LucaTomei/Electric-Scooter-Wheelchair/docs/speeches/V3-ENGLISH VERSION - DISCORSO TESI.pdf

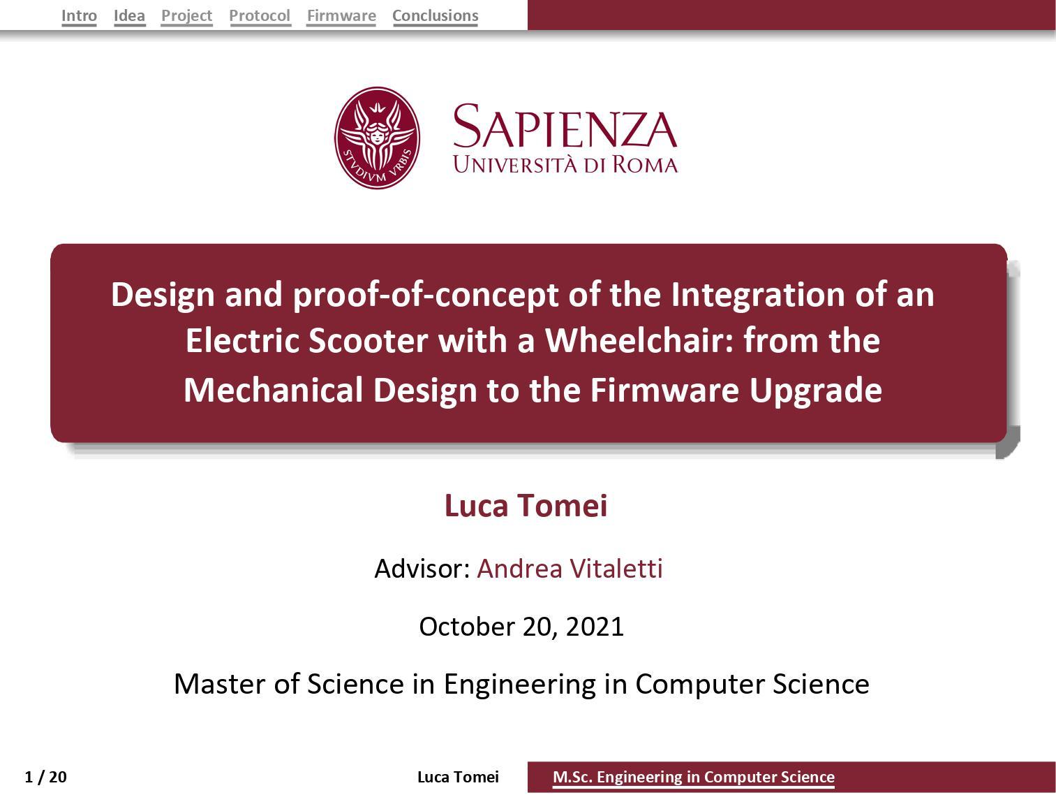
[picture p2: figure]

SLIDE 1
Good morning everyone, I'm Luca Tomei and I am going to show the presentation of my thesis work whose title is "Design and proof-of-concept of the Integration of an Electric Scooter with a Wheelchair: from the Mechanical Design to the Firmware Upgrade".

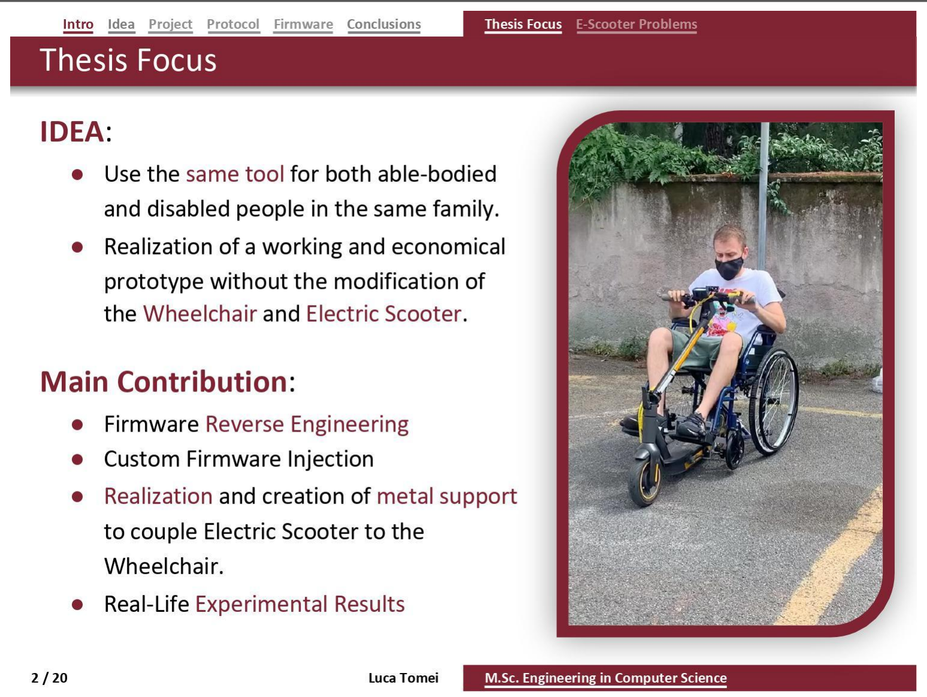
[picture p3: figure]

SLIDE 2
The aim of the project is to extend the use of an electric scooter to people with disabilities so that the same family can share the same means of motion. It was decided to not make any changes to neither the wheelchair nor the electric scooter, making as easy as possible for the two parts to be coupled and used together. But we have found two main problems: First. we must allow the electric scooter to start from a standstill and Second. we need to create the coupling of the two components.
Since the firmware of an electric scooter is owned by the manufacturer and is not available, it was decided to reverse engineer it by monitoring the packets exchanged between the smartphone and the vehicle.
As will be shown, this leads to a serious security problem in this IT product and after extracting and modifying the encrypted firmware, we made a steel bracket that allows attachment to a wheelchair. Finally, road tests were carried out to analyse the behavior of this software modification in order to make improvements and obtain data that would make driving safe without causing damage to people, battery or other components.

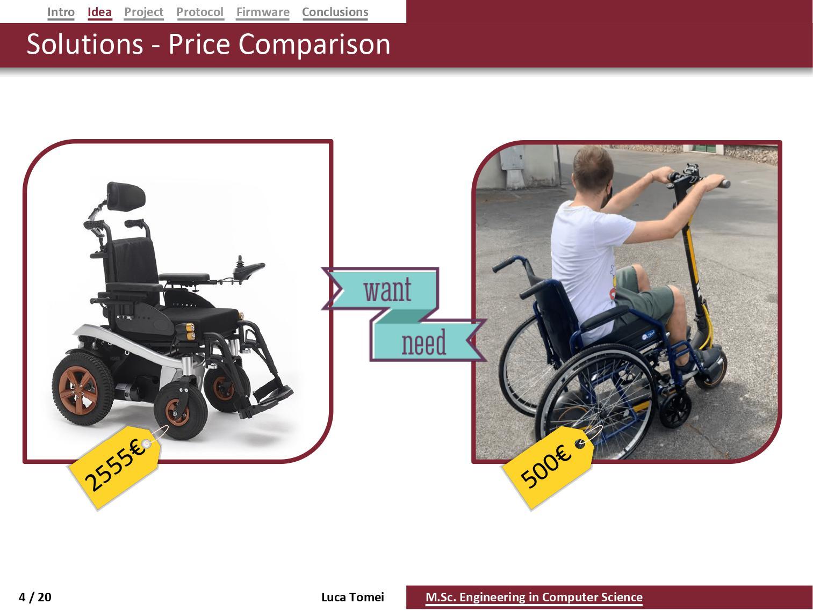
[picture p4: figure]

SLIDE 4
To overcome this problem, this project provides a different use of the wheelchair and electric scooter and, as is shown in this slide by a price comparison, it is possible to add traction to a normal wheelchair at a lower cost than a motorised one.

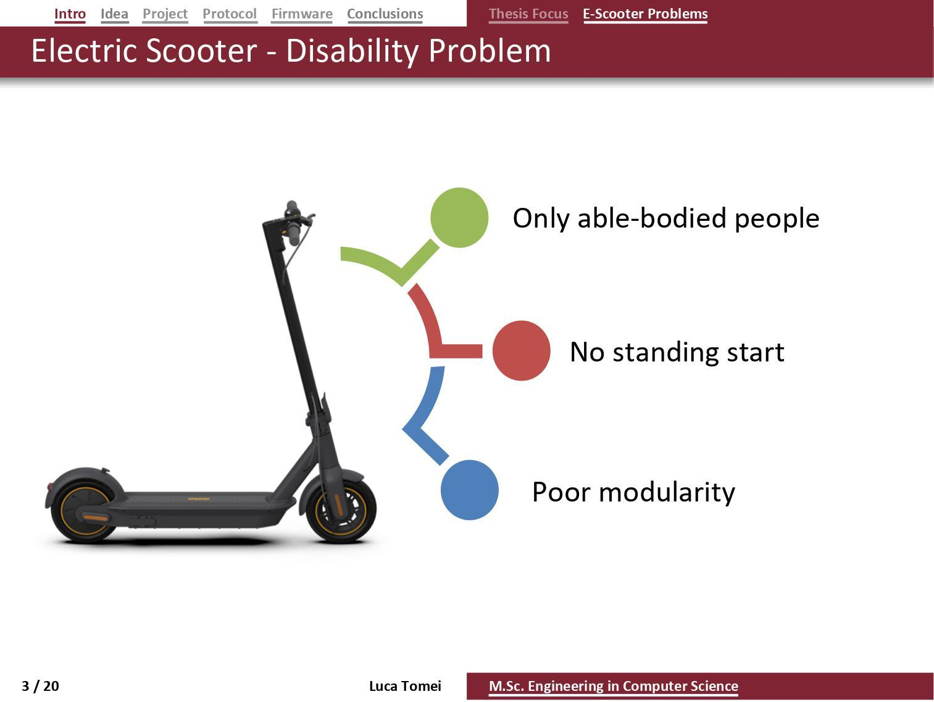
[picture p5: figure]

SLIDE 3
The popularity of electric scooters has increased in recent years.
However, the structure of such a vehicle imposes several constraints that apparently cannot be overcome by disabled people: for example, they can only be ridden by who can stand up and there is no possibility to start from a standstill as a small push with the feet is required to start the ride. Finally, electric scooters have little modularity, that is they are difficult to adapt to various uses.

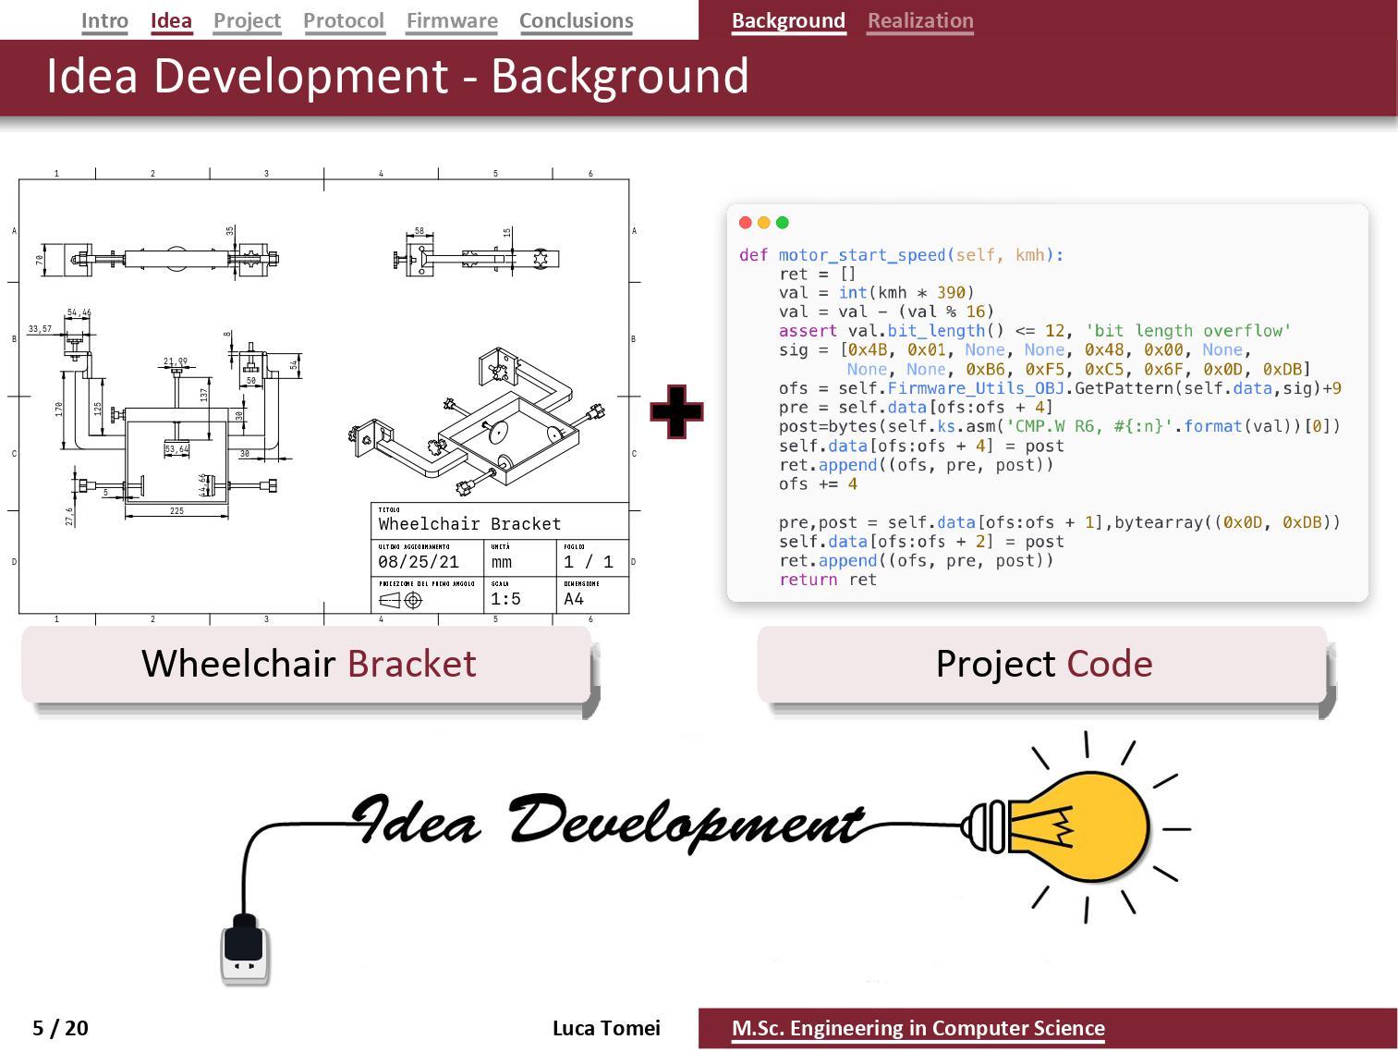
[picture p6: figure]

SLIDE 5
Very quickly I want to show a representative scheme that summarises the idea of my thesis project, which consists of the design and implementation of a metal support and the development of a custom firmware that allows the driveability of the electric scooter coupled to the wheelchair.

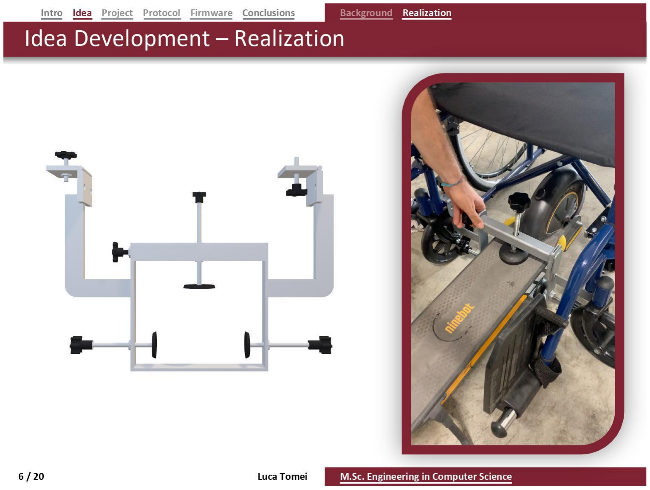
[picture p7: figure]

SLIDE 6
Here we can see how from the Autocad project we go to the concrete realisation of the bracket, which in the figure on the right is hooked to the wheelchair and installed near the rear wheels. This support, consisting of 3 knobs and 3 vibration dampers, allows the front wheels of the wheelchair to be raised and prevents longitudinal and transversal movements resulting from towing.

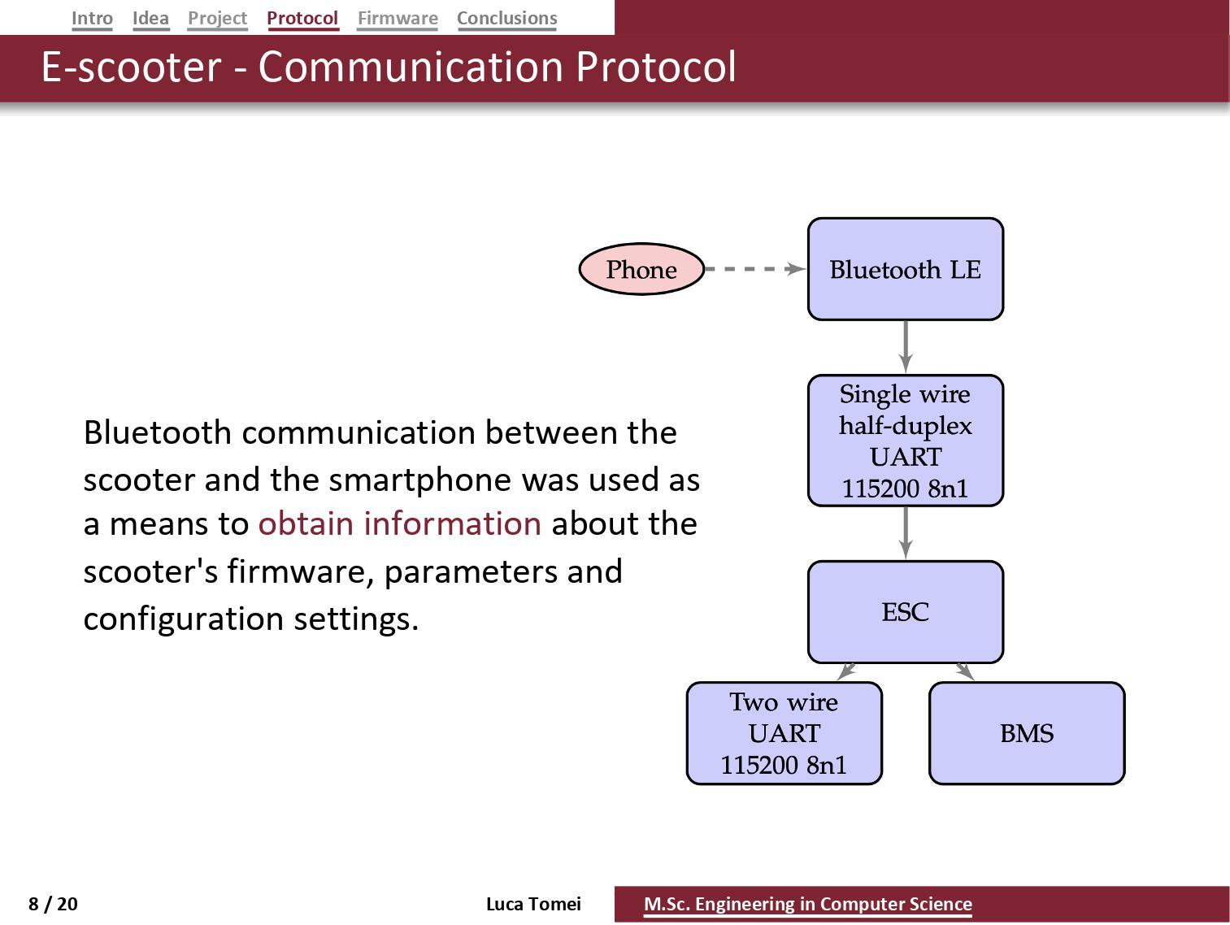
[picture p8: figure]

SLIDE 8
The process of interaction between the electric scooter and the smartphone takes place through Bluetooth connection as shown in the figure. This protocol defines the general format by which the Ninebot and Xiaomi electronic control system achieves multi-node communication via physical and Bluetooth serial ports. To use serial port communication must be used a baud rate of 1 hundred and 15 thousand 2 hundred, 8-byte word without verification and 1 stop bit. Information retrieval, control and parameter modification can be achieved through a read-write operation to the "memory control table" which is stored in the controller.

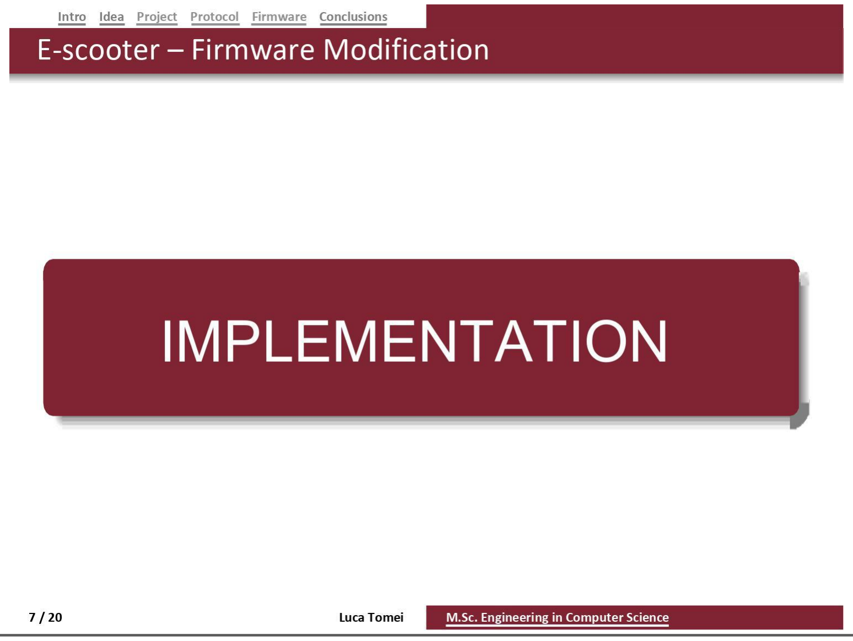
[picture p9: figure]

SLIDE 7
Now let's talk about the steps that made it possible to communicate with the vehicle and modify its parameters.

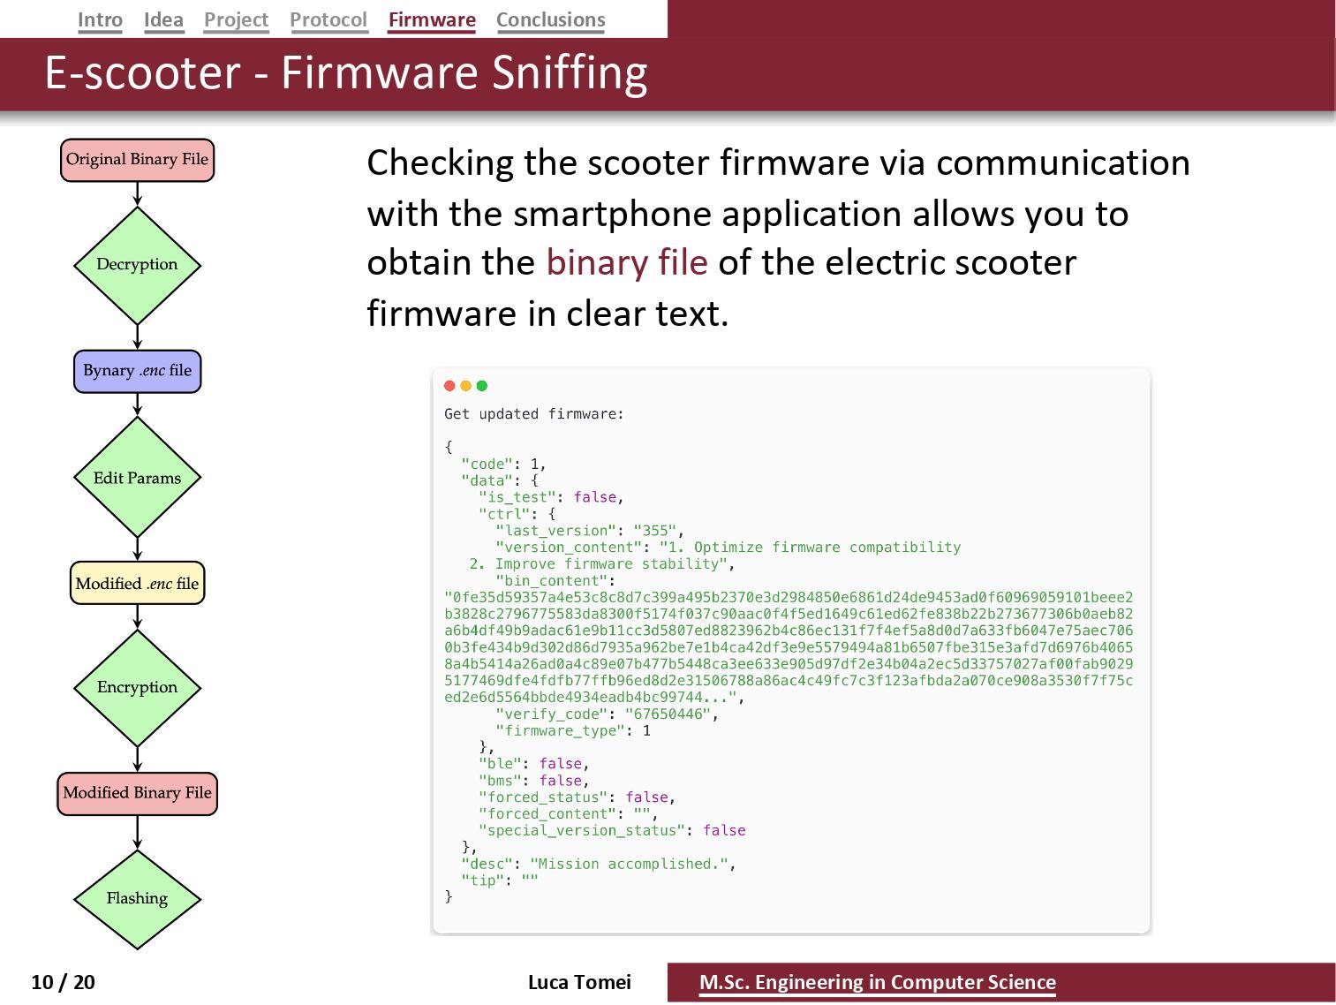
[picture p10: figure]

SLIDE 10
The original firmware cannot handle towing a wheelchair due to various limitations imposed by the manufacturer. For example, it is necessary to provide a standing start, increased acceleration, and limit speed in order to be used by people with disabilities.
Here you can see the block diagram that has been followed to perform a firmware modification. In particular, after obtaining the original firmware from the analysis of HTTPS packets exchanged with the smartphone, it is necessary to decrypt the binary file then proceed to change the parameters of interest. Finally, we need to encrypt the binary firmware and flash it on the memory of the electric scooter.

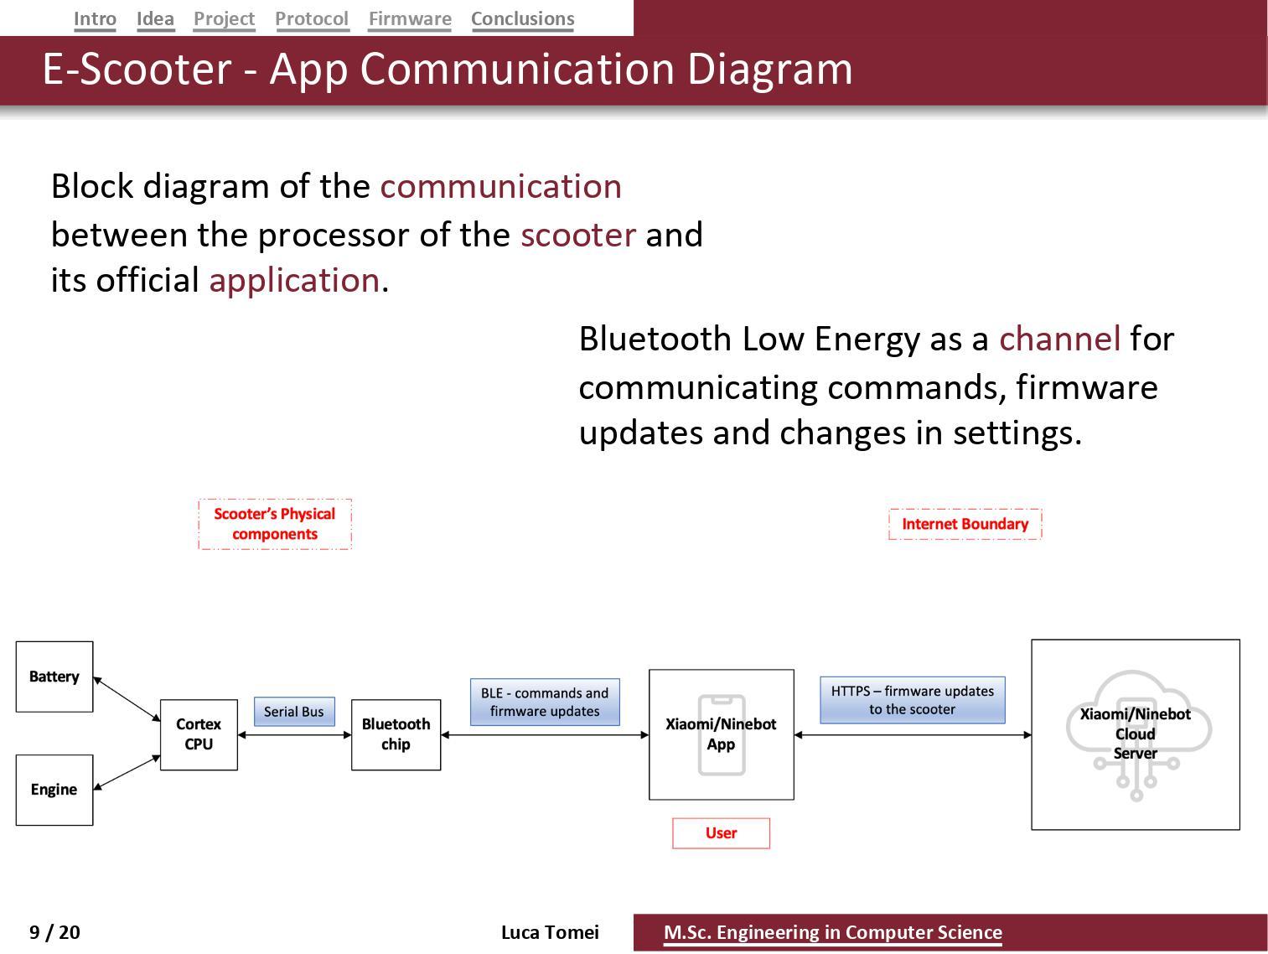
[picture p11: figure]

SLIDE 9
Extrapolating data from the GET/POST requests made by the application of the electric scooter connected to the phone, we realise that this technology is used as a means of issuing commands and transmitting various types of updates. Knowing how the two entities communicate is essential to proceed to modify the firmware parameters.

In fact, the figure below describes the various connection phases that the electric scooter performs while communicating with the parent cloud server. The user's application sends requests to the server, which immediately responds with updates for the vehicle. All this takes place under a Bluetooth connection between the smartphone and the chip in the electric scooter in order to issue commands to the control unit and the engine.

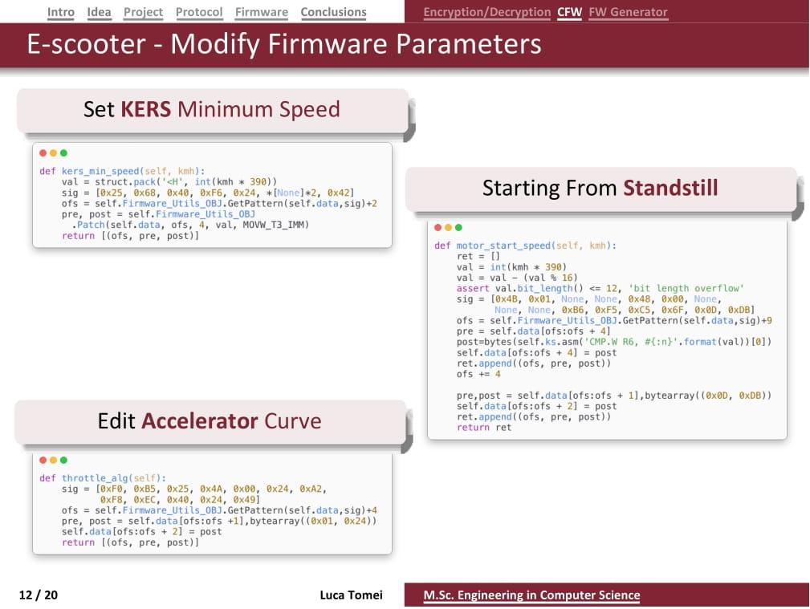
[picture p12: figure]

SLIDE 12
After decoding the binary file, we can proceed with modifying the parameters of interest like acceleration, KERS, starting speed, cruise control, motor power constant and top speed.
As you can see from the pieces of code shown, Python functions take various arguments as input, allowing you to modify those parameters according to your inclinations and needs.
Each function uses the auxiliary method "GetPattern" which is used to obtain the pattern in the binary structure of the data to be modified.
It takes the bitearray data structure as input and searches through it, returning the index to be used to modify the desired value.

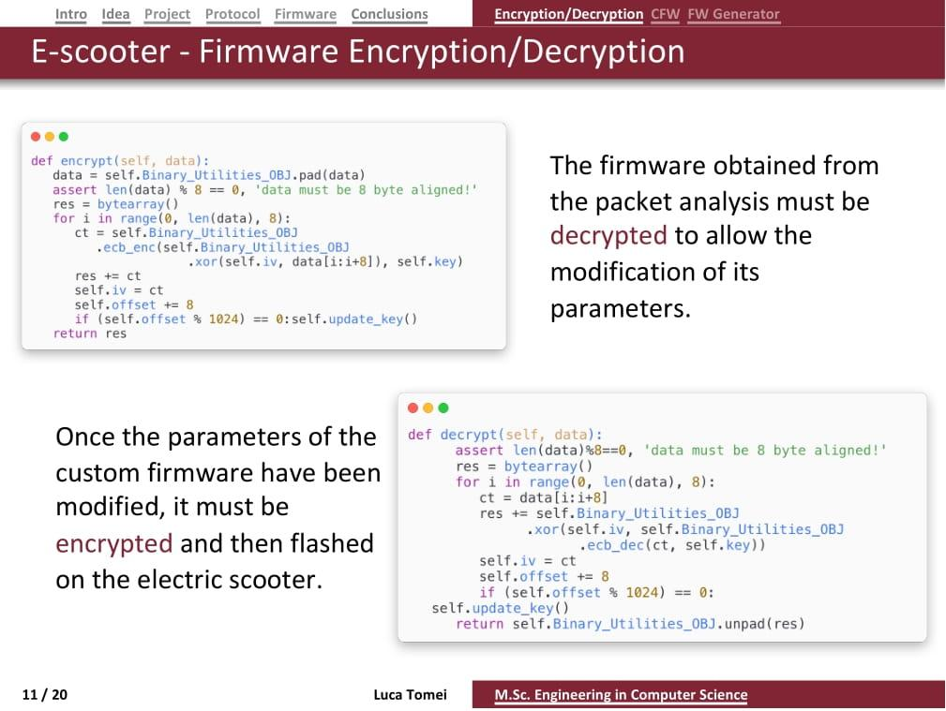
[picture p13: figure]

SLIDE 11
A first careful analysis of the binary file obtained from packet sniffing was performed with a decompiler that makes readable the values present in that data structure. Subsequently, various functions were implemented to encode and decode firmware of Xiaomi and Ninebot electric scooters. The first python function shown in this slide takes as input the "sniffed" file and returns as output a decrypted one that will be used to modify the parameters. The second function will be used last to make compatible the modified file with the original one, before flashing on the electric scooter.

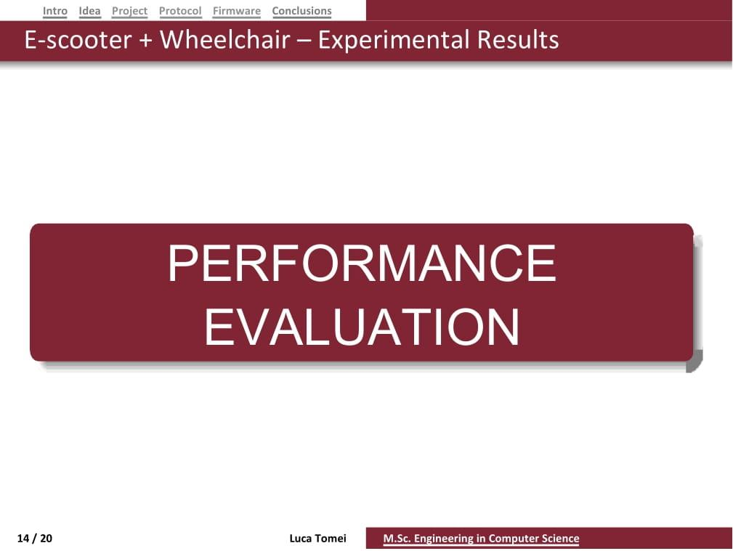
[picture p14: figure]

SLIDE 14
Now, we will illustrate several graphs aimed at showing the performance of the electric scooter both with the standard firmware, driven without the wheelchair, and with the customised firmware driven together with the wheelchair.

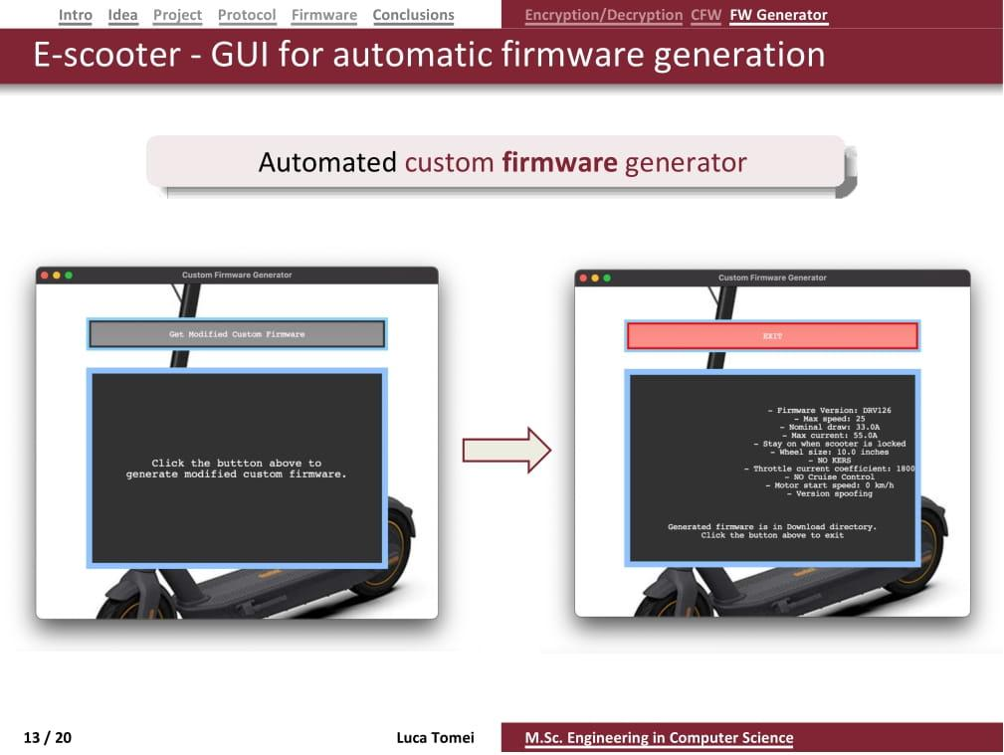
[picture p15: figure]

SLIDE 13
In order to facilitate and automate the creation of the custom firmware, a software with graphical interface has been created that, integrating the functions described above, generates a binary file ready for flashing on the electric scooter.

At the end of the wizard, by clicking the "EXIT" button the firmware will be saved in the download folder in ZIP format. At this point it will be sufficient to use one of the third part software available on AppStore or PlayStore to flash it on the vehicle and start the road test.

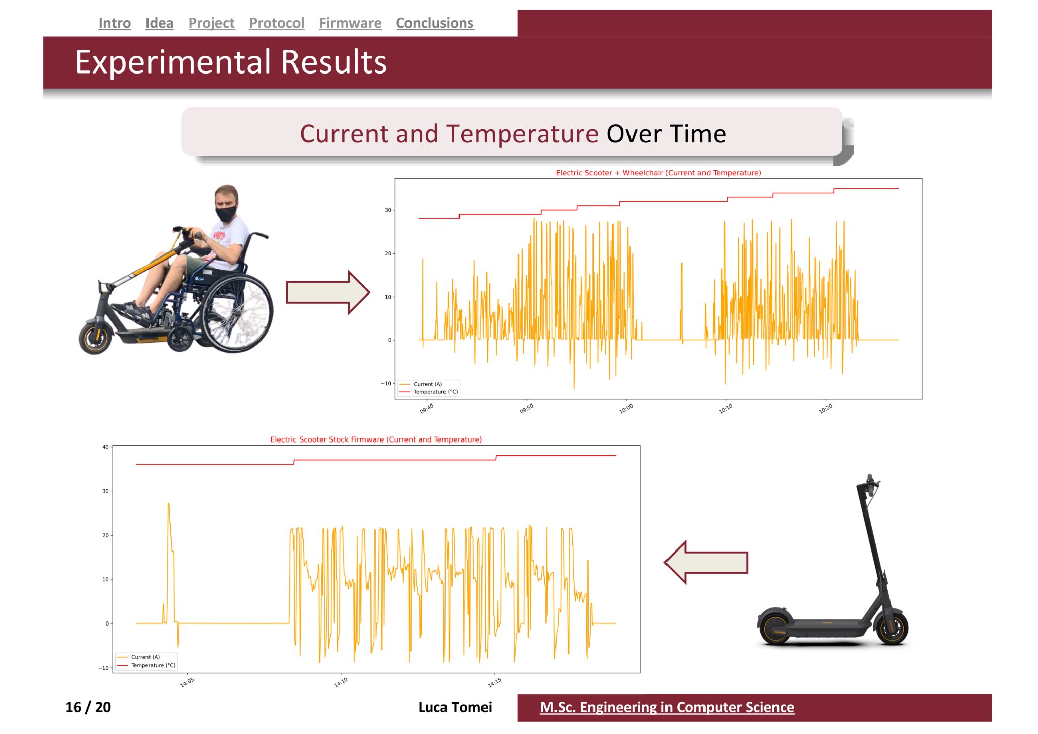
[picture p16: figure]

SLIDE 16
These figures show the trend in time of current and temperature. The current reaches positive peaks during acceleration and negative peaks during braking when the kinetic energy recovery system takes over. When the electric scooter is used with a wheelchair, the amplitude of these peaks is greater, so more energy will be recovered during braking.
It can be seen that the temperature is in the range of 28 to 34 Celsius degrees, which is a lower range than when used without a wheelchair. Operating at a lower temperature will extend the battery life and the kilometres travelled.

In the second figure we can see that the negative peaks are smaller in amplitude due to the reduced mass.
For the temperature we can observe that, as time passes, it is close to 40 degrees centigrade. This significant difference is due to the different law that regulates acceleration, a linear law that provides higher and more extended current levels in time.

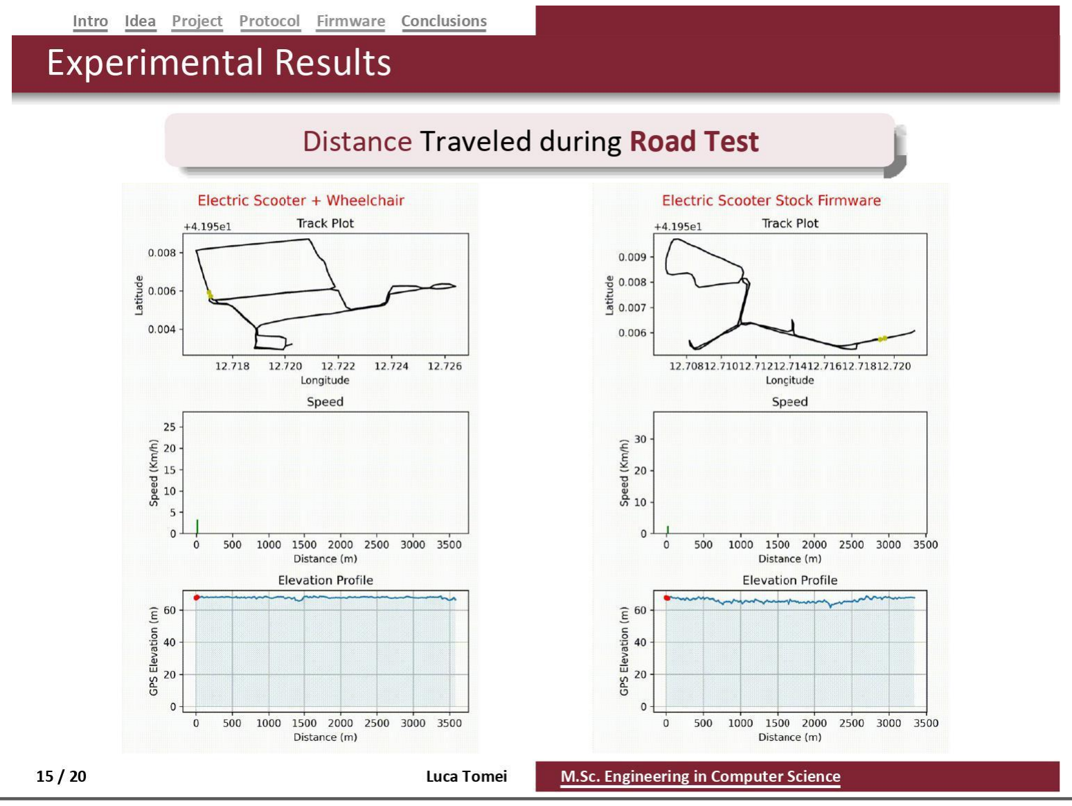
[picture p17: figure]

SLIDE 15
During the various road tests, we have collected data and then analysed and transformed using the Python matplotlib library to generate static and dynamic graphs regarding distance travelled, speed and slope of the ground. In order to analyse the differences in behaviour between the two firmwares, we tried to follow the same route for both test drives, which were carried out on a mostly flat road at a speed as constant as possible.

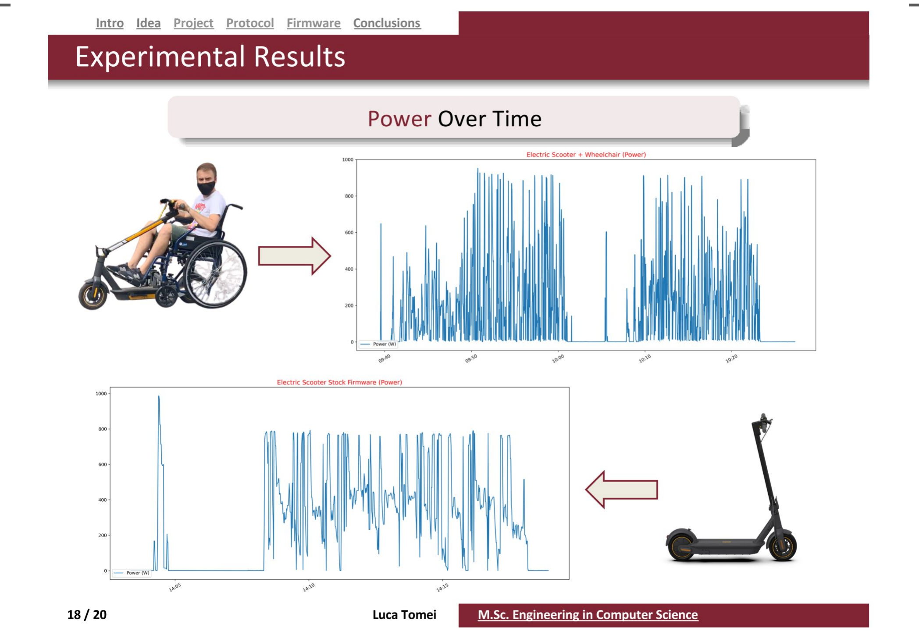
[picture p18: figure]

SLIDE 18
Regarding the power delivered by the engine, to ensure greater acceleration and starting from a standstill, the custom firmware generates peaks that are much higher than in the case of the stock one, who reaches the average power level of 780 watts compared to the 980 watts obtained when towing the wheelchair.

These values are related only to one of the three driving modes of the electric scooter, the sport mode, since during the customization of the firmware it was decided to leave the other two modes unchanged to ensure a longer battery life.

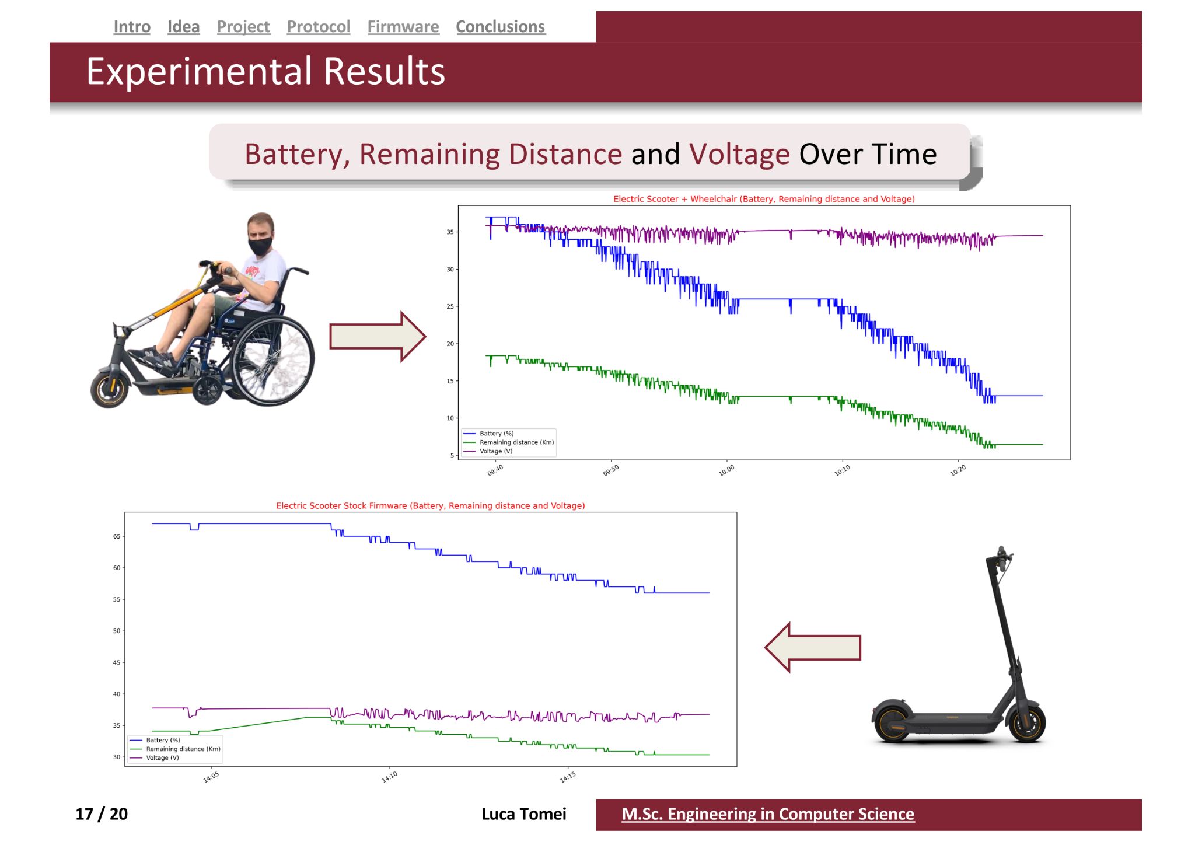
[picture p19: figure]

SLIDE 17
The following graphs show the trend of battery discharge, remaining distance and available voltage over time.
Obviously these three parameters depend directly on the weight of towed mass, in fact in the first case the discharge of the battery has a much steeper trend, the energy demand is very high but is compensated by the recovery system.

Instead in the second case we notice that the standard firmware guarantees a more contained use of the available energy and the energy recovery peaks are lower in amplitude and frequency.

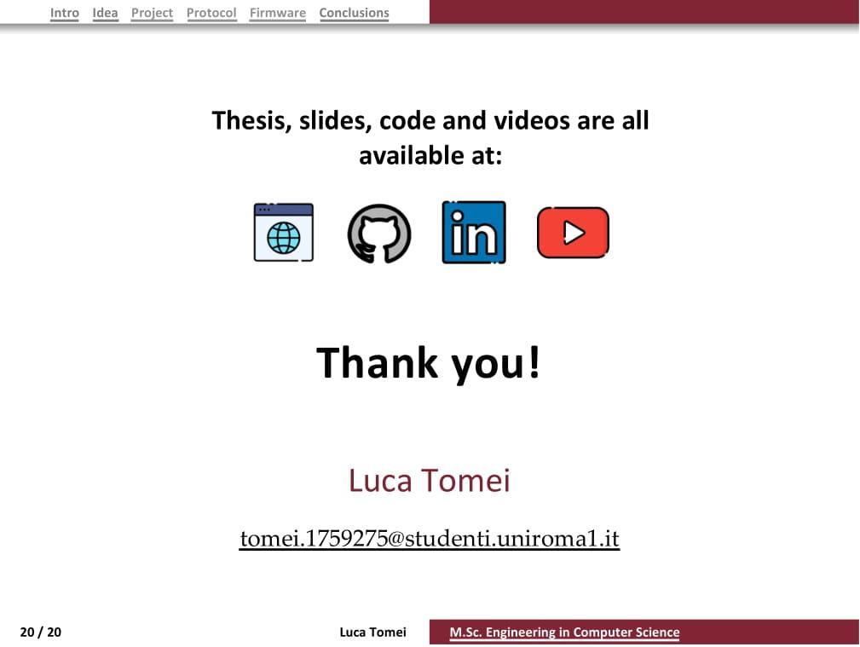
[picture p20: figure]

SLIDE 20
Thank you for your attention.

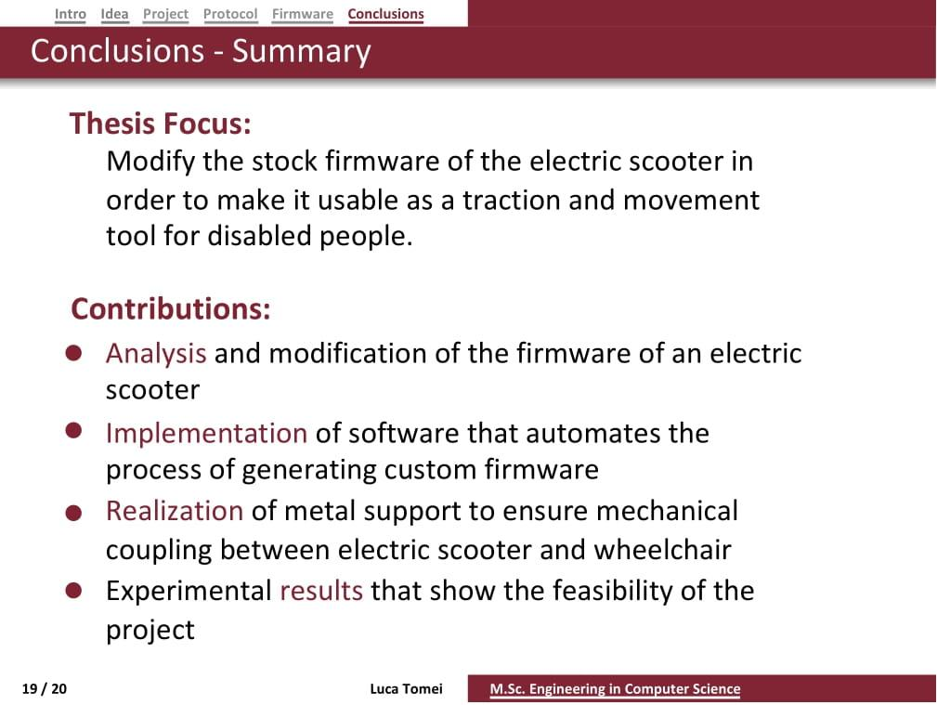
[picture p21: figure]

SLIDE 19
The main objective of this thesis was to demonstrate and realise the feasibility of having an economic solution that allow the use of the same means of motion by both able-bodied people and people with disabilities. Moreover, this result has been achieved without modifying in any way the structure of the electric scooter and the wheelchair. In fact, to allow the use of the electric scooter in this new field of use, it is only necessary the modification of the software and the realisation of the mechanical coupling between the two parts.
