LucaTomei/Electric-Scooter-Wheelchair/src/draw/data/1_carrozzina/IMG_3755.PNG

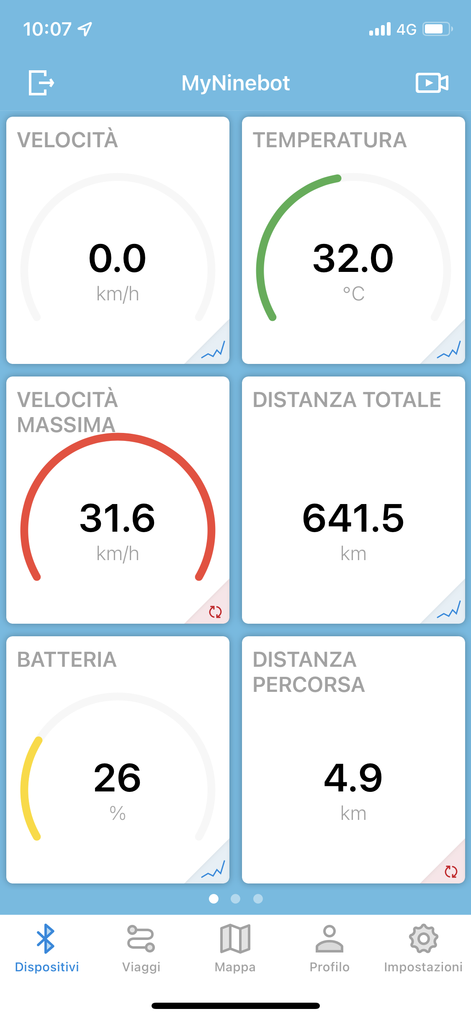
src/draw/data/1_carrozzina/IMG_3755.PNG
