LucaTomei/Electric-Scooter-Wheelchair/src/draw/data/1_carrozzina/IMG_3756.PNG

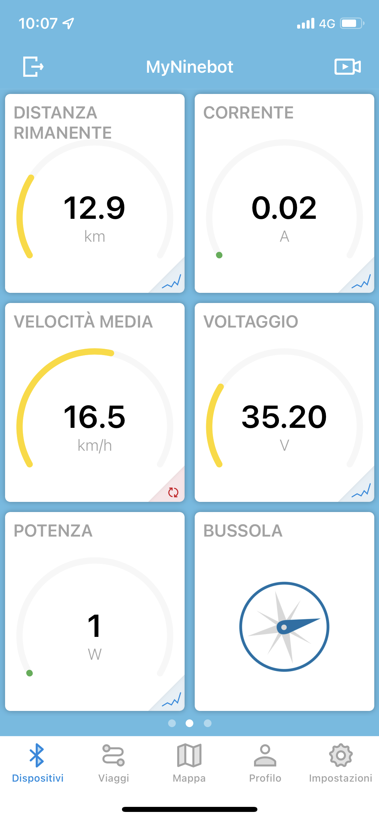
src/draw/data/1_carrozzina/IMG_3756.PNG
