LucaTomei/Electric-Scooter-Wheelchair/src/draw/data/2_carrozzina/IMG_3758.PNG

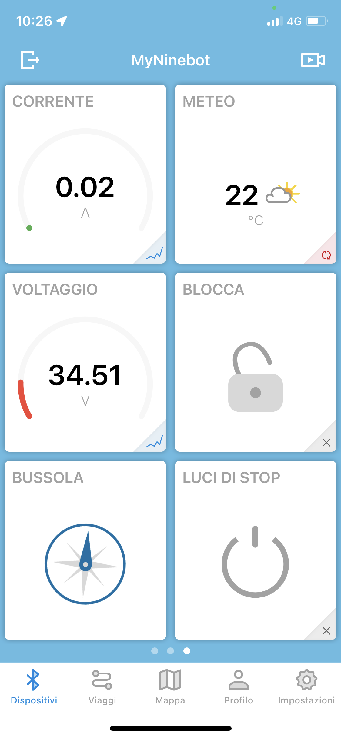
src/draw/data/2_carrozzina/IMG_3758.PNG
