LucaTomei/Electric-Scooter-Wheelchair/src/draw/data/only_scooter/IMG_3775.PNG

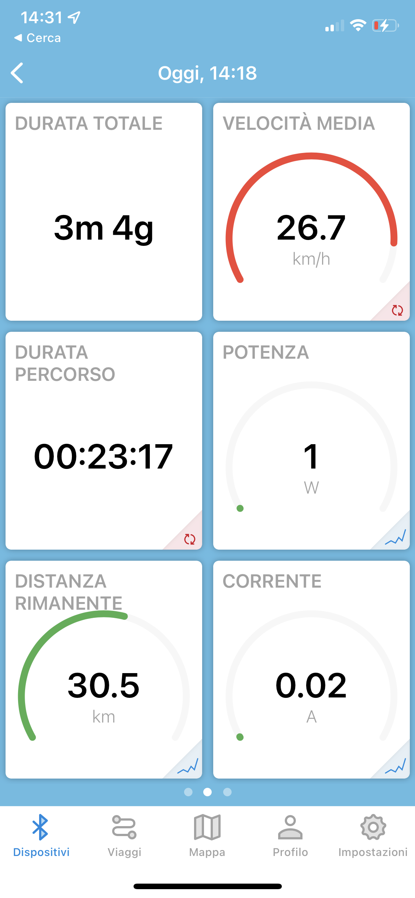
src/draw/data/only_scooter/IMG_3775.PNG
