LucaTomei/Electric-Scooter-Wheelchair/docs/aux/Wheelchair Bracket.stl

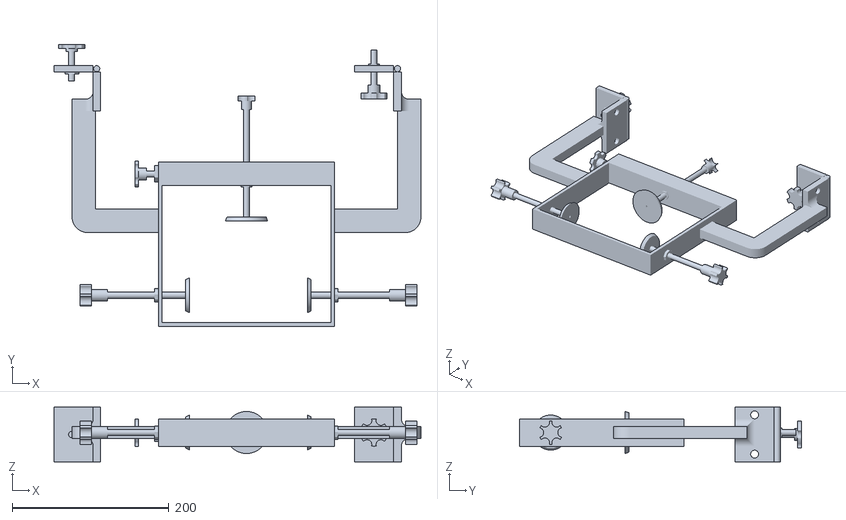
[picture p27: CAD file, 2021-08-26]
docs/aux/Wheelchair Bracket.stl
468.0 x 360.0 x 70.0
