LucaTomei/Electric-Scooter-Wheelchair/docs/aux/staffa_0.stl

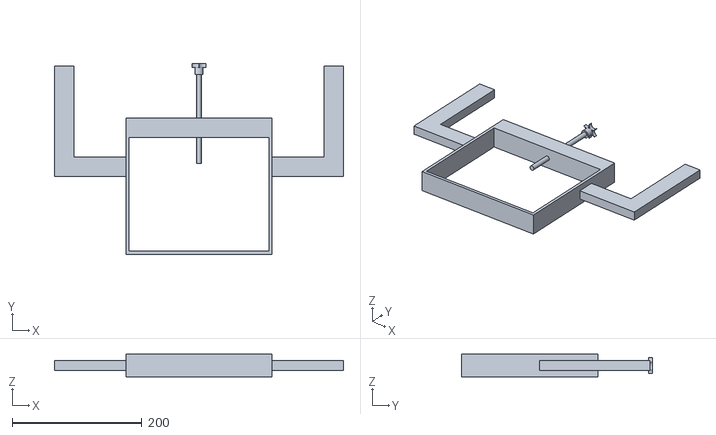
[picture p28: CAD file, 2021-08-11]
docs/aux/staffa_0.stl
445.0 x 294.0 x 35.0
