LucaTomei/Electric-Scooter-Wheelchair/(list of files, cad)

Other CAD files:
stl/staffa_.step
stl/Wheelchair Bracket.step
stl/Wheelchair_Bracket.f3d
stl/staffa_.3mf
