LucaTomei/Electric-Scooter-Wheelchair/(commit log)

2021-08-11 Added draw python file to draw electric scooter parameters graph
    [Batteria (1 giorno).csv, Batteria (1 minuto).csv, Batteria (1 ora).csv, Corrente (1 giorno).csv, Corrente (1 minuto).csv, Corrente (1 ora).csv, Distanza Rimanente (1 giorno).csv, Distanza Rimanente (1 ora).csv]
2021-08-26 Some fixes
    [Wheelchair Bracket.stl]
2021-08-27 some stuff
    [staffa_0.stl]
2021-08-27 New things
    [staffa_0.stl]
2021-09-22 Preparing to the latest commit
    [Wheelchair Bracket.stl, staffa_0.stl]
2021-10-18 Push before Thesis presentation
    [Wheelchair Bracket.step, Wheelchair Bracket.stl, Wheelchair_Bracket.f3d, staffa_.3mf, staffa_.step, staffa_0.stl]
