LucaTomei/Electric-Scooter-Wheelchair/(notices)

Notices in the files:
README.md:
gpl-3.0
